emptthy/Dosificador/Informe/Informe.docx

ESCUELA DE EDUCACION SECUNDARIA TECNICA N° 5 “2 DE ABRIL” – TEMPERLEY – BUENOS AIRES

DOSIFICADOR

MATERIA : PROYECTO Y DISEÑO ELECTRONICO

FECHA : 1/11/2024

AUTORES:

Apolinario lautaro, lapolinario643@gmail.com

Asinelli Luca, lucanasinelli@gmail.com

Bustamante Santiago, busstamantesantiago@gmail.com

Frete Nicolas, nicofrete2005@gmail.com

Galvan Franco, francogustavogalvann@gmail.com

NOMBRES Y MAIL

PROFESOR: ING. MARTIN LEGUIZAMON

## ▶ Indice

▷ Resumen...................................................................................................3

▷ Introduccion teorica.................................................................................4

ESP32................................................................................................4

MotorPAP...........................................................................................5

A4988.................................................................................................6

Display................................................................................................7

Teclado...............................................................................................8

StepDown...........................................................................................9

▷ Descripción etapa por etapa..................................................................10

Etapa 1...............................................................................................10

Etapa 2...............................................................................................11

▷ Materiales y costos.................................................................................12

Etapa 1...............................................................................................12

Etapa 2...............................................................................................13

▷ Imagen general........................................................................................14

▷ Diagrama de gantt...................................................................................15

Conclusión..........................................................................................15

▷ Bibliografía...............................................................................................16

▷ Diseños 3D...............................................................................................17

Base movible......................................................................................17

Soporte motor.....................................................................................17

Soporte jeringa 1................................................................................18

Soporte jeringa 2................................................................................18

Soporte inicial.....................................................................................18

Soporte display...................................................................................19

Soporte placa......................................................................................19

Soporte teclado...................................................................................19

▷ Códigos....................................................................................................20

Etapa 1...............................................................................................20

Etapa 2...............................................................................................22

GitHub: https://github.com/emptthy/Dosificador

▶ Descripción

Este proyecto consta de una base de varillas y rulemanes, que servirán como soporte para una jeringa, la cual contendrá el líquido que queramos inyectar, para luego ser empujada por un motor paso a paso al marcar en un teclado la cantidad de la dosis solicitada.

▶ Objetivo

Tenemos como objetivo brindar una manera de poder inyectar cualquier tipo de líquido, ya sea medicamento o cualquier otro producto químico, de manera milimétrica.

▶ Introduccion Teorica

Los componentes que están en el proyecto, su función principal y el motivo por el uso de estos mismos son los siguientes:

- Esp32:

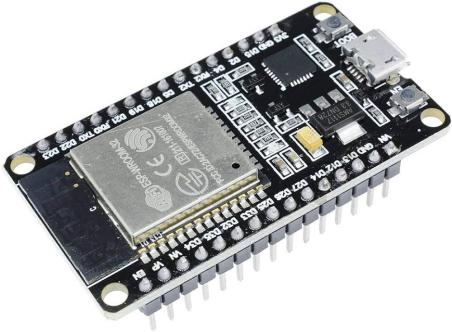
[picture p1: figure]
esp 32

- La razón principal del porque usamos este micro-controlador fue por su facilidad de uso y su compatibilidad con los demás componentes del proyecto.

- Con su doble núcleo, el ESP32 es suficientemente potente para manejar tareas complejas de manera simultánea, como controlar el motor paso a paso, procesar las señales del teclado, y monitorear sensores para mayor precisión en la dosificación.

- El ESP32 es muy adecuado para controlar motores paso a paso, ya que ofrece una frecuencia de pulso estable, necesaria para movimientos precisos. Esto es fundamental en nuestro proyecto, ya que el motor deberá empujar la jeringa con precisión para entregar la dosis exacta solicitada.

- También cuenta con varios pines GPIO, suficientes para conectar el teclado, el motor paso a paso, sensores y otros periféricos sin requerir hardware adicional. Esto simplifica el diseño y reduce el costo.

- Al ser programable en el entorno de Arduino, el ESP32 ofrece una curva de aprendizaje moderada, ideal para desarrollar y probar rápidamente el código necesario para el dispositivo de dosificación.

- El ESP32 es relativamente económico, ofreciendo un excelente balance entre costo y funcionalidad. Esto ayuda a mantener el costo general del proyecto bajo, sin sacrificar capacidades técnicas.

Motor PAP (Paso a Paso):

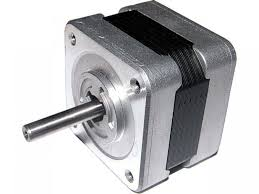
[picture p2: figure]
motor

- El motor NEMA 17 es capaz de realizar movimientos incrementales con alta precisión, generalmente en pasos de 1.8 grados por paso (200 pasos por vuelta). Esto permite controlar de manera precisa el desplazamiento del émbolo de la jeringa, garantizando una dosificación exacta.

- El NEMA 17 es conocido por su capacidad de par (torque) adecuado para aplicaciones de empuje o carga moderada, como es el caso de la presión necesaria para inyectar un líquido en una jeringa. Este par proporciona suficiente fuerza para empujar el émbolo sin problemas y sin pérdida de pasos, lo cual es crucial para asegurar una dosificación controlada.

- Al ser uno de los motores paso a paso más comunes, el NEMA 17 tiene una estructura y tamaño estándar que permite su fácil integración en la mayoría de proyectos mecánicos, con soportes y acoples fácilmente disponibles. Esto simplifica el montaje en la base de varillas y rulemanes del proyecto.

- Los motores paso a paso NEMA 17 son fáciles de controlar en términos de velocidad y dirección, lo cual es útil para ajustar la rapidez con la que se mueve el émbolo de la jeringa y adaptarse a distintos tipos de líquidos o dosis requeridas.

Driver A4988:

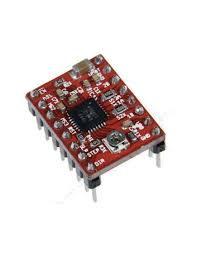
[picture p3: figure]
driver

- El A4988 permite controlar el motor en modo de microstepping (hasta 1/16 de paso), lo que mejora la suavidad y precisión del movimiento del émbolo en la jeringa. Esto es útil para dosis pequeñas o incrementos específicos, asegurando que el empuje sea lo más exacto posible.

- Este driver es ampliamente compatible con microcontroladores como el ESP32, lo que simplifica la programación y el control del motor. Solo necesitas enviar señales de pulso y dirección para controlarlo, lo cual reduce la complejidad de la conexión y configuración.

- El A4988 cuenta con un potenciómetro para ajustar la corriente máxima que pasa al motor, protegiéndolo de sobrecargas y asegurando un funcionamiento seguro. Además, incluye protecciones térmicas, lo cual es ideal para evitar daños si el motor se usa de manera prolongada en aplicaciones de alta carga, como el empuje de una jeringa.

- El A4988 es ideal para motores de bajo a medio consumo, como el NEMA 17, y puede manejar corrientes de hasta 2A (con disipador), lo cual es suficiente para la mayoría de aplicaciones sin exigir demasiado al driver.

- Este driver incluye protecciones integradas contra sobrecorriente y bajo voltaje, asegurando que el sistema funcione de manera segura y evitando daños en caso de fluctuaciones en la fuente de alimentación o exceso de carga.

- Puedes alimentar el A4988 con un voltaje de hasta 35V, lo cual permite controlar motores de diferentes voltajes y adaptar la potencia necesaria según las necesidades de empuje de la jeringa.

Display i2c 16x2:

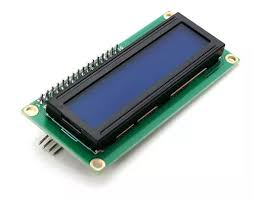
[picture p4: figure]
display

- Este tipo de display utiliza el protocolo I2C, lo que reduce el número de pines necesarios para la comunicación (solo necesitas dos: SDA y SCL). Esto simplifica las conexiones con el ESP32, liberando pines para otros componentes, como el teclado y el motor paso a paso.

- El display de 16x2 puede mostrar hasta dos líneas de texto de 16 caracteres cada una, suficiente para mostrar mensajes claros como la dosis seleccionada, el estado del sistema (por ejemplo, "Inyectando" o "Listo"), o advertencias si algo falla. Esto facilita la interacción del usuario con el sistema, brindándole retroalimentación en tiempo real.

- Este tipo de display consume poca energía, lo cual es ideal si el sistema necesita operar de manera eficiente sin exigir demasiada potencia adicional.

- Los displays I2C 16x2 son ampliamente compatibles con el ESP32 y otras plataformas, y cuentan con muchas bibliotecas de código abierto, lo que simplifica la programación y configuración.

- El display I2C 16x2 es compacto y fácil de montar en la estructura de tu sistema, sin requerir mucho espacio. Su tamaño es ideal para incluirlo en la carcasa o estructura sin afectar el diseño general.

Teclado de membrana:

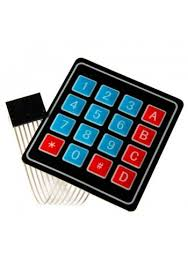
[picture p5: figure]
teclado

- Un teclado 4x4 ofrece 16 teclas que pueden utilizarse para ingresar dosis precisas, seleccionar opciones o confirmar instrucciones, lo cual permite una interacción sencilla con el sistema. Esto es especialmente útil para que el usuario ingrese la cantidad deseada de líquido a dosificar de forma rápida y sin complicaciones.

- Aunque los teclados 4x4 requieren varios pines (8 en total para filas y columnas), son compatibles con microcontroladores como el ESP32, y existen bibliotecas (como la biblioteca Keypad.h) que facilitan su integración y manejo, simplificando la lectura de las teclas.

- El teclado permite al usuario recibir una respuesta inmediata en el display 16x2 cada vez que se presiona una tecla. Esto ayuda a confirmar visualmente el número ingresado, reduciendo el riesgo de errores en la dosificación.

- El teclado es pequeño y compacto, por lo que puede montarse en la estructura del sistema sin ocupar demasiado espacio. Además, son económicos, lo cual ayuda a mantener bajo el costo general del proyecto.

Step down xi6009:

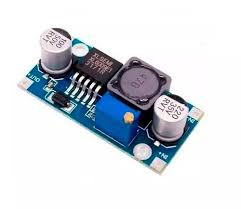
[picture p6: figure]
step down

- El Xi6009 permite convertir un voltaje de entrada más alto en un voltaje de salida regulado, protegiendo los componentes sensibles como el ESP32, el display y el teclado de picos de voltaje. Esto es ideal si se esta usando una fuente de alimentación de mayor voltaje (por ejemplo, una batería de 12V o 24V).

- El Xl6009 admite un rango de voltaje de entrada de hasta 32V y puede reducirlo a voltajes de salida de 1.25V a 30V. Esto te da flexibilidad para ajustar la salida exacta que necesitas para cada parte del sistema, como el motor paso a paso o el ESP32, adaptándose a los requisitos específicos de cada componente.

- Este regulador es muy eficiente, logrando una conversión de hasta el 90%, lo cual minimiza la pérdida de energía en forma de calor. Esto es especialmente útil en dispositivos alimentados por batería, ya que optimiza el uso de la energía, extendiendo la duración de la batería y evitando problemas de sobrecalentamiento.

- El Xl6009 puede suministrar hasta 4A de corriente, lo cual es suficiente para alimentar tanto el motor paso a paso como otros componentes del sistema de dosificación, asegurando que cada componente reciba la corriente que necesita para funcionar correctamente.

- El Xl6009 cuenta con un potenciómetro que permite ajustar manualmente el voltaje de salida a valores precisos. Esto es útil para configurarlo de acuerdo con las necesidades exactas de cada componente, como el ESP32 (que necesita 5V o 3.3V) o el motor paso a paso, evitando la necesidad de múltiples reguladores.

▶ Descripción etapa por etapa

『 Etapa 1 』

En esta el proyecto se encontraba en desarrollo.El primer modelo de este tenia doble faz y un código mucho mas complejo. El procedimiento de fabricación de la placa fue bastante complejo por los componentes y modelos utilizados durante esta etapa

Como se puede observar en el primer modelo del PCB contiene doble faz. Un lado es la imagen de la derecha y otro es la imagen de la izquierda. Aparte en este primer modelo hay componentes que en la segunda etapa ya no están, esto para simplificar la placa para ahorrar materiales y tiempo. Esta era demasiado compleja ya que al tener demasiados componentes no era fácil conectarlos entre si.

『 Etapa 2 』

En esta segundo etapa el PCB y el código se simplificaron en gran parte por los elementos que fueron removidos , otro cambio importante es que dejamos de utilizar doble faz para hacer mas eficiente la placa.

Como se puede observar en este PCB un cuarto de los componentes fue eliminado para poder ejecutar el proyecto con mayor eficiencia y que no fuera tan complejo a la hora de montarlo. Uno de estos componentes eliminados son los capacitores SMD (En gran parte) y también se adapto de mejor manera la alimentación interna y el ESP32. Se implementaron cables que sirven como puente para los 5V facilitando asi la conexion. En conclusión la segunda etapa del proyecto nos ayudo a entender y a simplificar mas el proyecto.

▶ Materiales y costos

▷ Etapa 1 ◁

Varillas Templadas: $12000 ARS

Varilla enroscada: $2500 ARS

Rodamientos lineales: $5000 ARS

Jeringa: $2000 ARS

Display: $3000 ARS

Teclado: $1500 ARS

Esp-32: $10000 ARS

Fuente 12v: $4000 ARS

Motor paso a paso: $20000 ARS

Sensor posición: $20000 ARS

Capacitores SMD: $1200 ARS

Total estimado: $81200 ARS

▷ Etapa 2 ◁

Varillas Templadas: $12000 ARS

Varilla enroscada: $2500 ARS

Rodamientos lineales: $5000 ARS

Jeringa: $2000 ARS

Display: $3000 ARS

Teclado: $1500 ARS

Esp-32: $10000 ARS

Fuente 12v: $4000 ARS

Motor paso a paso: $20000 ARS

Total estimado:80000 ARS

▶ Imagen general del proyecto

▶ Diagrama de Gantt

▶ Conclusión

La conclusión más grande de este proyecto en gran parte seria que fue un proyecto demasiado ambicioso y complicado, y al no tener muchas fabricaciones y ser algo novedoso nos costo entenderlo al principio , pero cuando ya supimos bien de los que se trataba , al entender mejor los componentes y al saber como solucionar cada problema facilito la construcción del mismo. Las mejoras que podríamos haber hecho serian principalmente el tiempo de fabricación de la placa y haber notado la facilidad de hacer la placa simple y no de doble faz.

▶ Bibliografía

Además MM de la unidad, el controlador también contiene los tamaños de jeringas de 1, 2, 5, 10, 20, 30, 50 ml, y cambia automáticamente a ML ml después de la selección.

Se adopta riel de guía redondo de acero inoxidable de 8mm de diámetro, rodamiento extendido con brida. La varilla de tornillo adopta plomo T8, tornillo de 1mm, tuerca de tornillo de cobre.

La sujeción adopta un bloque de presión, sujeción de tuerca de mano M4

El motor es el motor de 42 pasos, se adopta el motor de par grande. La vuelta única se establece en 400 pasos.

Controlador,pantalla de cristal líquido 1602,4 botones pueden configurar la velocidad, el tiempo de trabajo, el modo de trabajo y los otros 4 botones para controlar las máquinas, respectivamente, movimiento de velocidad fija y movimiento de alta velocidad. El parámetro SET ahorra el almacenamiento de energía. Pulsación rápida botón Añadir. Interfaz de nivel TTL reservado para la placa. El botón de control también tiene una interfaz externa que se puede utilizar para la interfaz. Apague El interruptor externo y el interruptor de pie, etc. Puede conectar controladores externos como ordenadores y PLC.

▶ Diseños 3D:

Base movible

Soporte de motor

Soporte jeringa 1

Soporte jeringa 2

Soporte incial

Soporte display

Soporte placa

Soporte teclado

Códigos

▷ Etapa 1 ◁

▷ Etapa 2 ◁

Profesor: Leguizamon, Martin E.E.S.T.N°5 “2 de Abril” 7°6
