emptthy/Dosificador/Archivos 3D/soporte varilla 2.stl

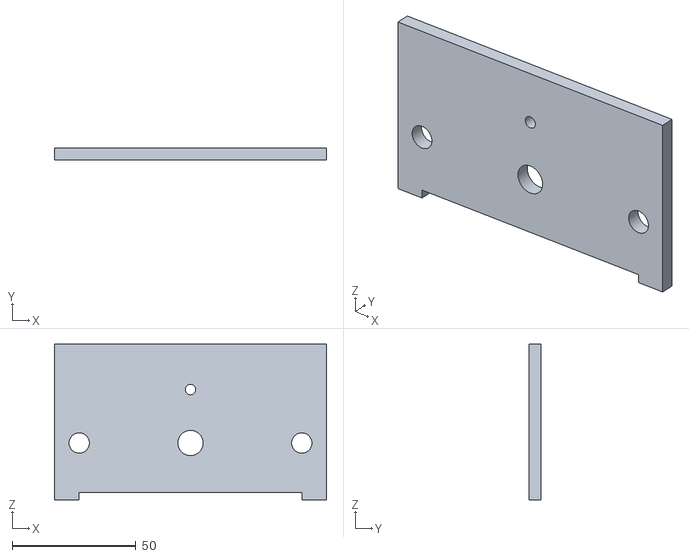
[picture p7: CAD file, 2024-11-22]
Archivos 3D/soporte varilla 2.stl
110.0 x 5.00 x 63.0
