emptthy/Dosificador/Archivos 3D/soporte  varilla.stl

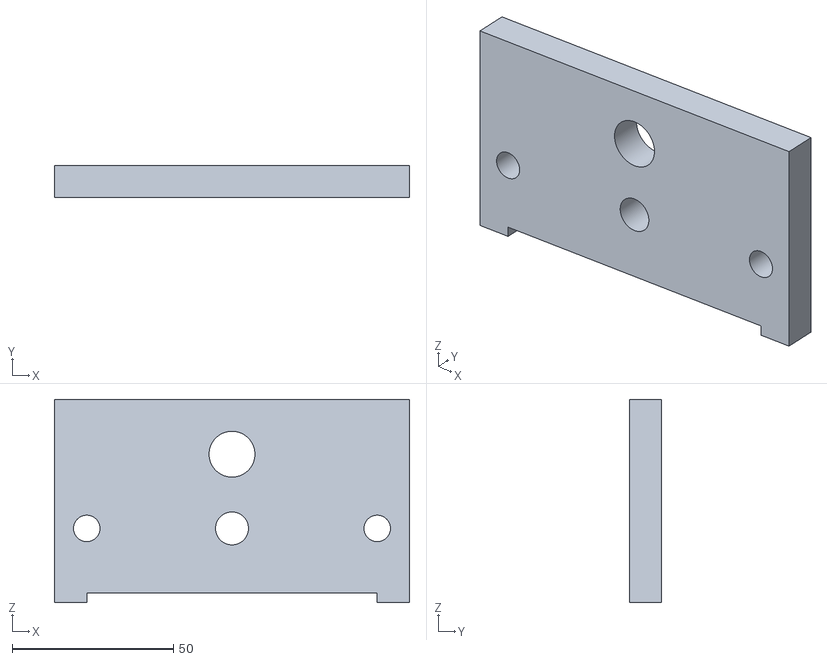
[picture p8: CAD file, 2024-11-22]
Archivos 3D/soporte varilla.stl
110.0 x 10.0 x 63.0
