emptthy/Dosificador/Archivos 3D/NEMA17-1.STL

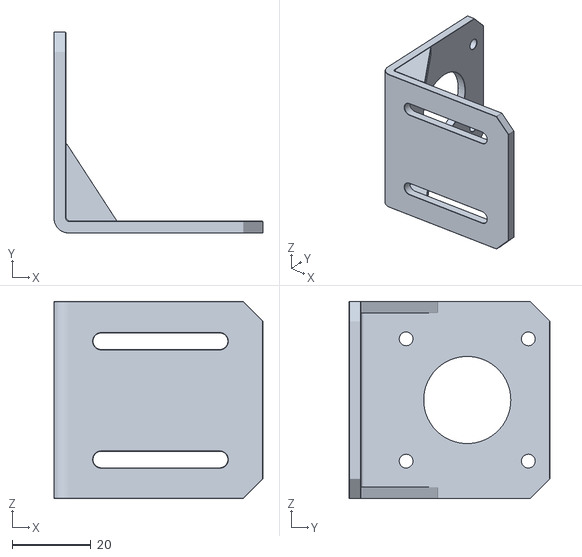
[picture p9: CAD file, 2024-11-22]
Archivos 3D/NEMA17-1.STL
53.0 x 51.0 x 50.0
