emptthy/Dosificador/Archivos 3D/base movible .stl

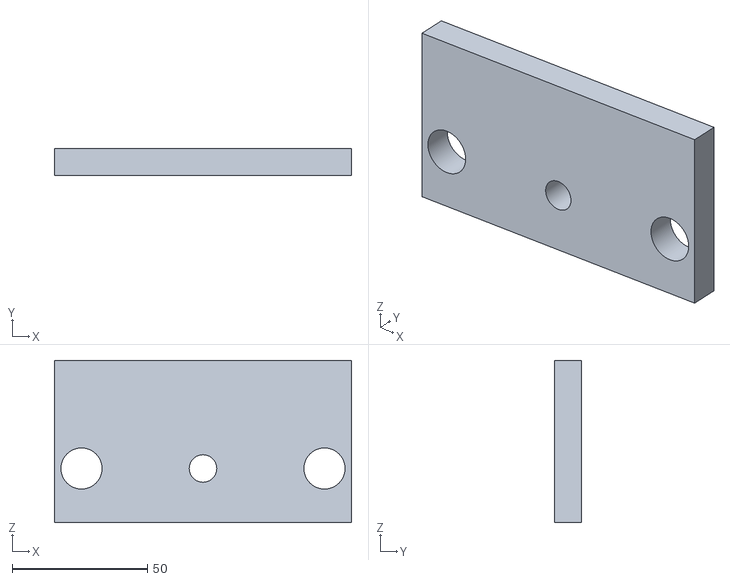
[picture p10: CAD file, 2024-11-22]
Archivos 3D/base movible .stl
110.0 x 10.0 x 60.0
