emptthy/Dosificador/Archivos 3D/soporte teclado .stl

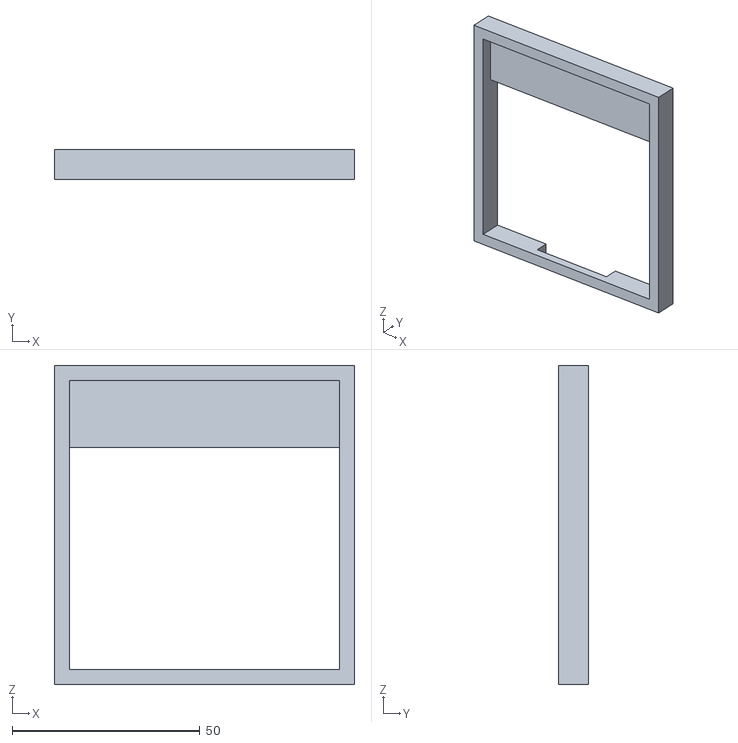
[picture p11: CAD file, 2024-11-22]
Archivos 3D/soporte teclado .stl
80.0 x 8.00 x 85.0
