emptthy/Dosificador/Archivos 3D/soporte placa.stl

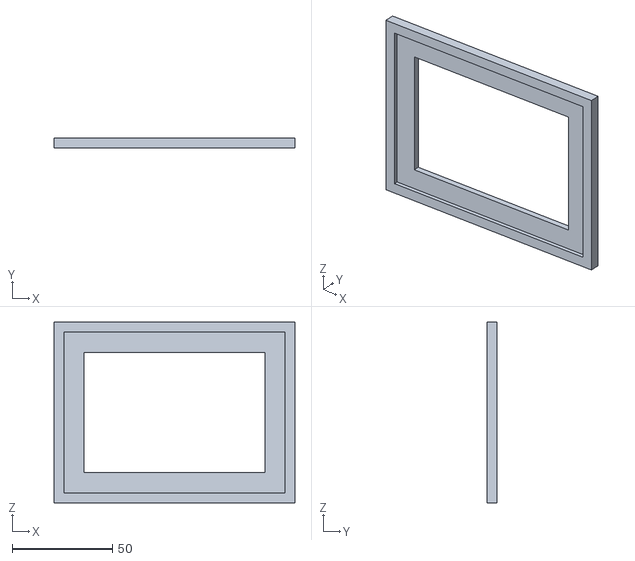
[picture p12: CAD file, 2024-11-22]
Archivos 3D/soporte placa.stl
120.0 x 5.00 x 90.0
