emptthy/Dosificador/Archivos 3D/soporte lcd.STL

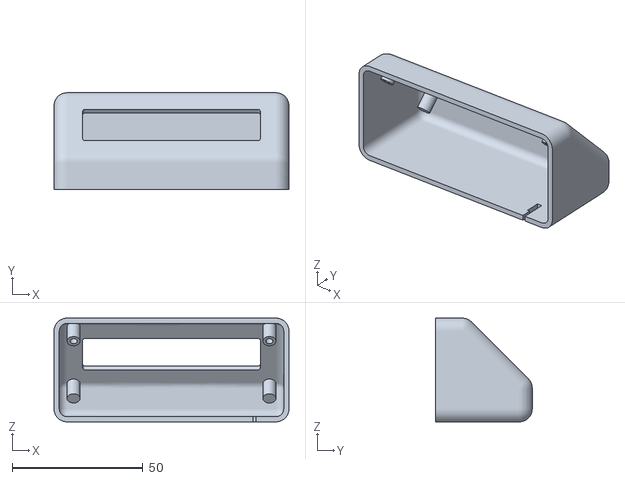
[picture p13: CAD file, 2024-11-22]
Archivos 3D/soporte lcd.STL
90.0 x 37.0 x 39.7
