emptthy/Dosificador/Archivos 3D/soporte inicial.stl

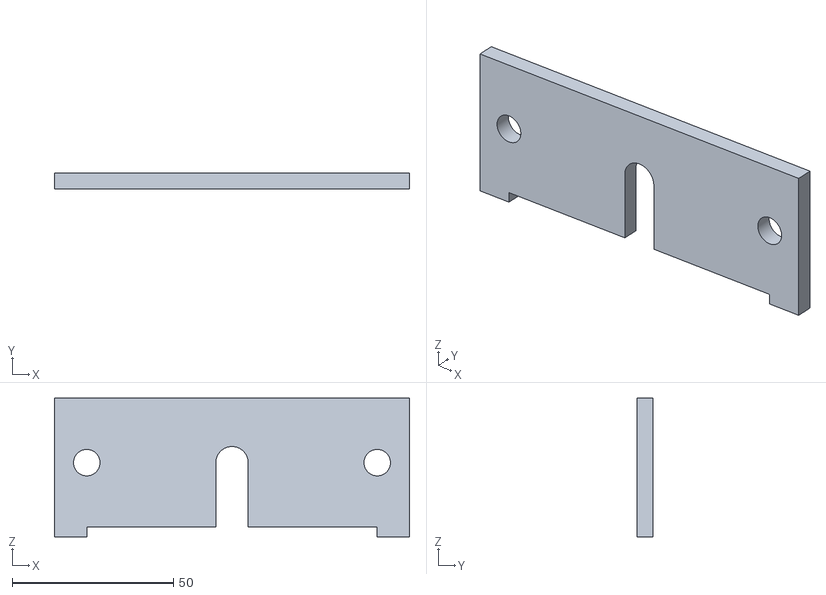
[picture p14: CAD file, 2024-11-22]
Archivos 3D/soporte inicial.stl
110.0 x 5.00 x 43.0
