emptthy/Dosificador/Kicad/DOSIFICADOR XDDD.kicad_pcb

## KiCad design Kicad/DOSIFICADOR XDDD.kicad_pcb (2024-11-22)

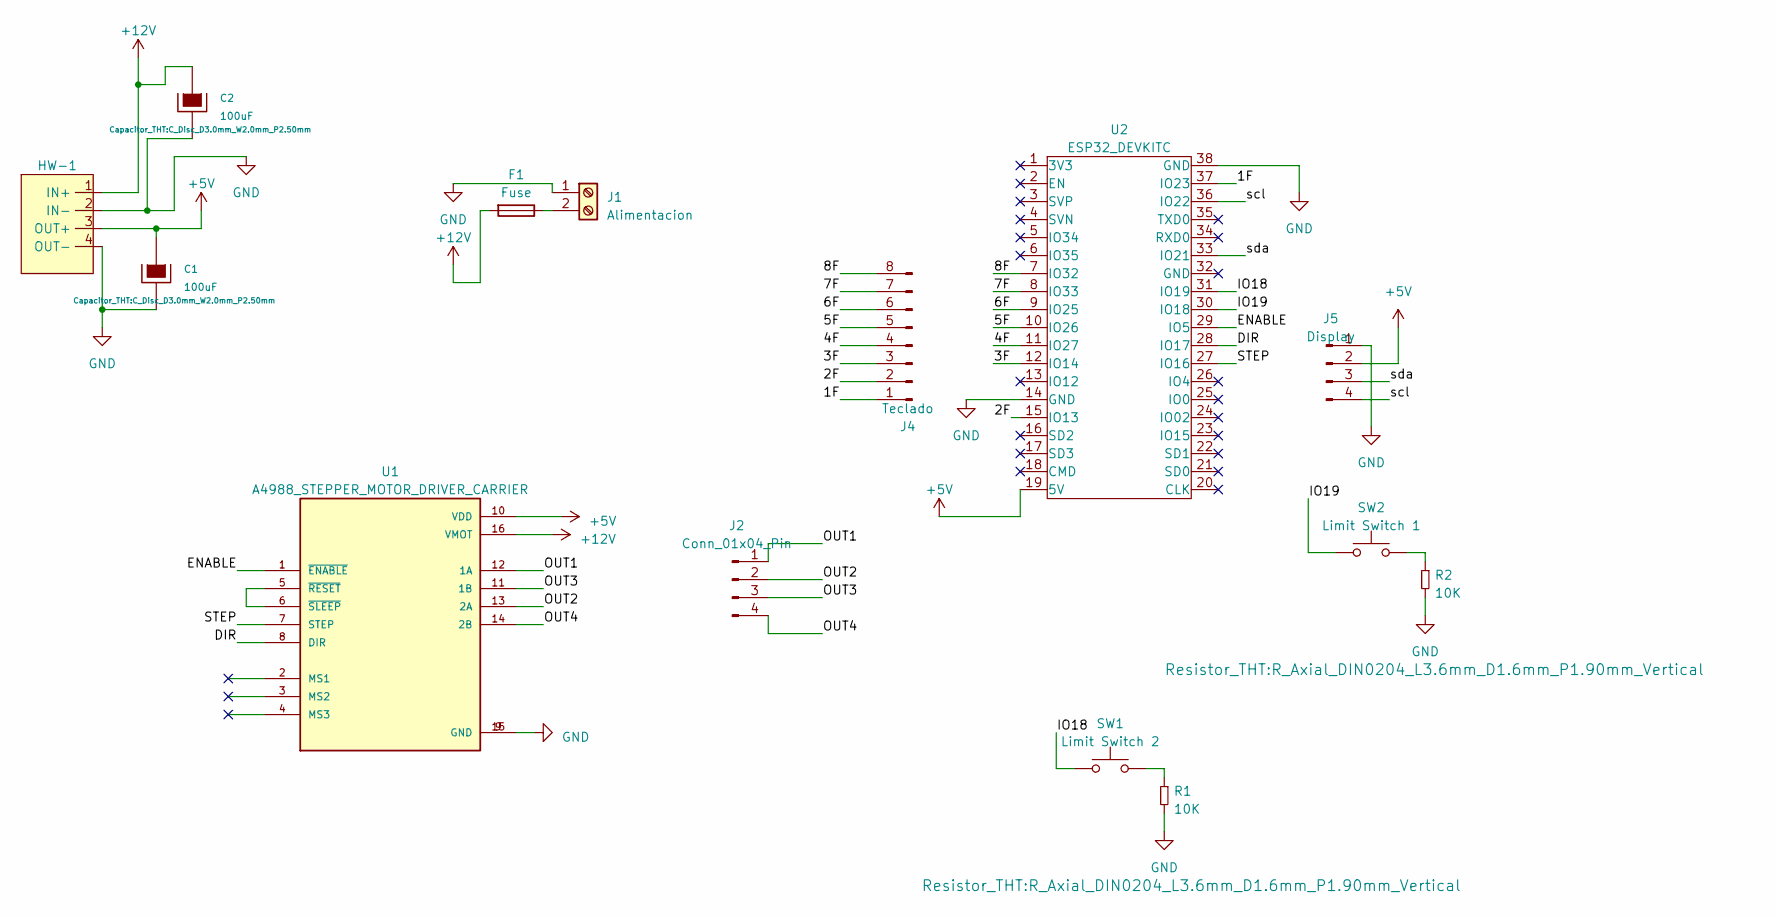
[picture p15: schematic DOSIFICADOR XDDD.kicad_sch]

Parts:
C1, C2: 100uF; C_Disc_D3.0mm_W2.0mm_P2.50mm
F1: Fuse; Fuse_Bourns_MF-RG300
HW-1: stepdown
J1: Alimentacion; BORNERA2_AZUL
J2: Conn_01x04_Pin; PinHeader_1x04_P2.54mm_Vertical
J4: Teclado; Pin_Header_Straight_1x08
J5: Display; pin_strip_4
R1, R2: 10K; R_Axial_DIN0204_L3.6mm_D1.6mm_P1.90mm_Vertical
SW1: Limit Switch 2; PinHeader_1x02_P2.00mm_Vertical
SW2: Limit Switch 1; PinHeader_1x02_P2.00mm_Vertical
U1: A4988_STEPPER_MOTOR_DRIVER_CARRIER; MODULE_A4988_STEPPER_MOTOR_DRIVER_CARRIER
U2: ESP32_DEVKITC

Connections:
+5V: C1.1, HW-1.3 (OUT+), J5.2, U1.10 (VDD), U2.19 (5V)
+12V: C2.1, F1.2, HW-1.1 (IN+), U1.16 (VMOT)
/1F: J4.1, U2.37 (IO23)
/2F: J4.2, U2.15 (IO13)
/3F: J4.3, U2.12 (IO14)
/4F: J4.4, U2.11 (IO27)
/5F: J4.5, U2.10 (IO26)
/6F: J4.6, U2.9 (IO25)
/7F: J4.7, U2.8 (IO33)
/8F: J4.8, U2.7 (IO32)
/DIR: U1.8 (DIR), U2.28 (IO17)
/ENABLE: U1.1 (~ENABLE), U2.29 (IO5)
/IO18: SW1.1, U2.31 (IO19)
/IO19: SW2.1, U2.30 (IO18)
/OUT1: J2.1, U1.12 (1A)
/OUT2: J2.2, U1.13 (2A)
/OUT3: J2.3, U1.11 (1B)
/OUT4: J2.4, U1.14 (2B)
/STEP: U1.7 (STEP), U2.27 (IO16)
/scl: J5.4, U2.36 (IO22)
/sda: J5.3, U2.33 (IO21)
GND: C1.2, C2.2, HW-1.2 (IN-), HW-1.4 (OUT-), J1.1, J5.1, R1.2, R2.2, U1.9 (GND), U1.15 (GND), U2.14 (GND), U2.38 (GND)
unnamed: F1.1, J1.2
unnamed: R1.1, SW1.2
unnamed: R2.1, SW2.2
unnamed: U1.5 (~RESET), U1.6 (~SLEEP)

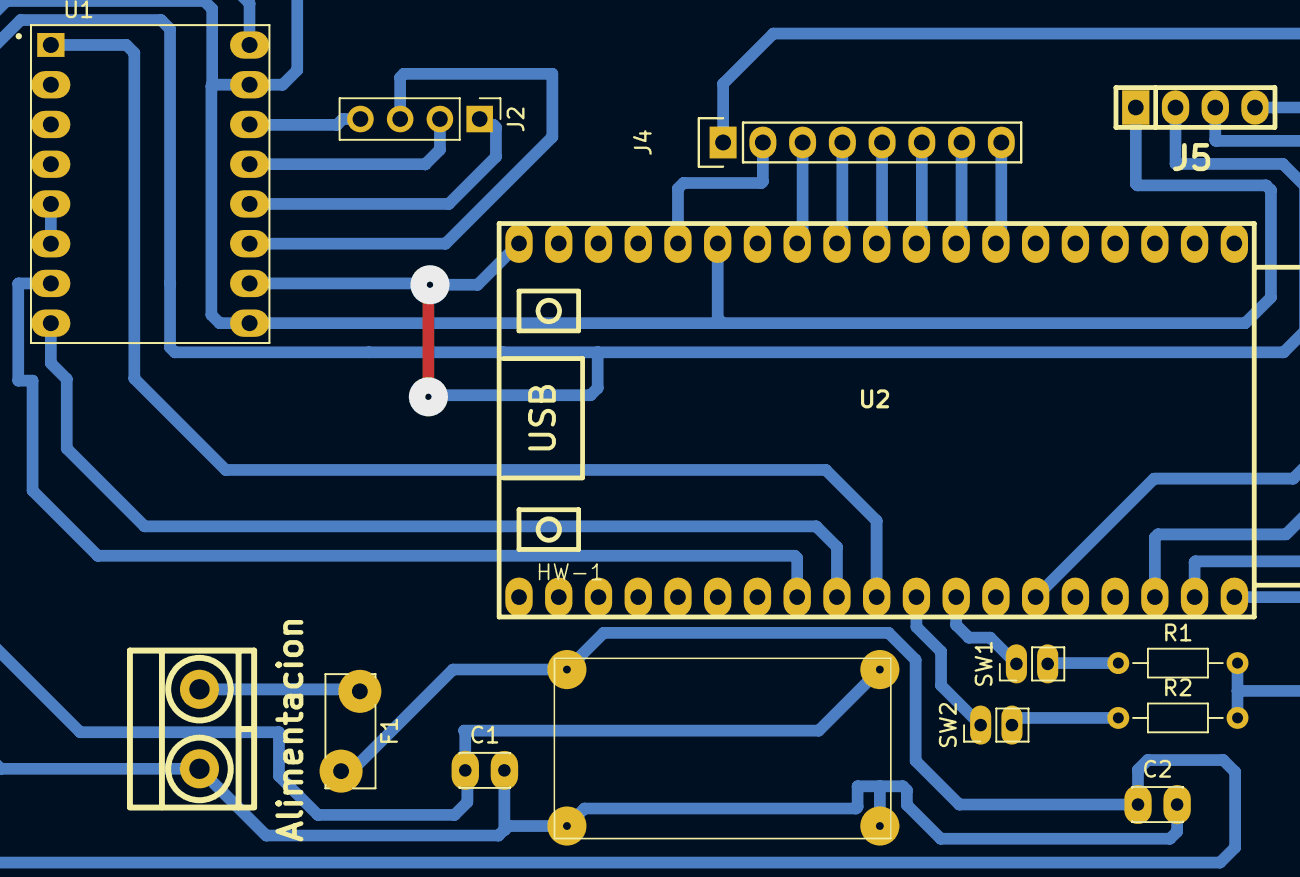
[picture p16: board DOSIFICADOR XDDD.kicad_pcb from above]

Board: 2 copper layers, 14 parts (0 on the bottom side), 26 nets.
